rpavlik/PS2-Breakout-Board/PS2-Breakout-single.kicad_pcb

## KiCad design PS2-Breakout-single.kicad_pcb (2019-10-01)

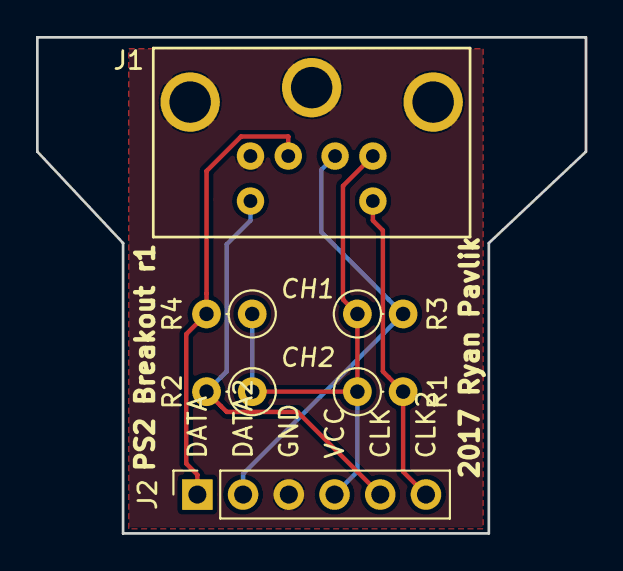
[picture p1: board PS2-Breakout-single.kicad_pcb from above]

Board: 2 copper layers, 30.5 x 27.6 mm, 6 parts (0 on the bottom side), 6 nets.

Parts:
J1: PS2-MINIDIN6-FEMALE; MINI-DIN-6-FULL-SHIELD
J2: Conn_01x06_Male; PinSocket_1x06_P2.54mm_Vertical
R1, R2, R3, R4: 10K; R_Axial_DIN0207_L6.3mm_D2.5mm_P2.54mm_Vertical

Connections:
/CLK: J1.5, J2.5, R2.2
/CLK2: J1.6, J2.6, R1.2
/DATA: J1.1, J2.1, R4.2
/DATA2: J1.2, J2.2, R3.2
GND: J1.3, J1.7, J2.3
VCC: J1.4, J2.4, R1.1, R2.1, R3.1, R4.1
