rpavlik/PS2-Breakout-Board/(threads)

Thread 2 (2017-07-26):

Fix PS/2 socket footprint

rpavlik, 2017-07-26:
Holes for actual pins are a bit too small. Alignment: not sure, worth double-checking with a fresh socket that I haven't monkeyed with.

Also, the center mounting/grounding pin hole could probably be a little bit bigger - it does go in, and it does look like it's designed to snap in, but a little more room is probably not a bad idea.

Thread 6 (2017-07-26):

Adjust silkscreen outline for PS2 socket

rpavlik, 2017-07-26:
It only needs to be roughly as wide as the distance between the center of the two ground/mounting holes - not the full width that it is now. That means it should probably be a broken box to avoid conflicts with the pads.

Thread 7 (2017-07-27):

PS/2 socket footprint mirrored in r1

rpavlik, 2017-07-27:
This would be my big "oopsie" for the R1 board - I apparently got the pinout of the port mirrored when making the footprint. This means a few things, if you connect a port and keyboard without board rework:

- Channel 1 (data/clk) and Channel 2 (data2/clk2) are swapped - no big deal except...
- GND and VCC are swapped (so now you're pulling down to gnd and you've got vcc on your ground plane, as well as your shield, etc... - basically a dead short once you plug a keyboard in...)

## Workarounds:

### The hard way
- On the board front, cut a trace (to what I thought was VCC) and the thermal connections to the ground plane (to what I thought was GND)
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

- After mounting the port, solder small wires on the back of the board to replace those traces.
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

- Use the pullup pads and pinouts labeled for ch2 instead of ch1, since they're swapped.

### The easy way
Of course, realized only after I had already done the above. If your mounting requirements allow (and frankly, you could realistically change all board component mounting since it's pretty simple and all through-hole...)

*put the PS/2 port on from the "back side" of the board* - this will mirror the pins back, and everything will work the way it's supposed to.  (facepalm)
