rpavlik/PS2-Breakout-Board/(commit log)

2017-07-26 Initial commit - gitignore backups and gerber/drill
2017-07-26 Revision 1 plus some alternate historical layouts.
    [PS2-Breakout.kicad_pcb, PS2-Breakout.sch, attempt-without-reorg.kicad_pcb, good-dual-layer-no-fills.kicad_pcb]
2017-07-26 Remove old backup copies of pcb
    [attempt-without-reorg.kicad_pcb, good-dual-layer-no-fills.kicad_pcb]
2017-07-26 Add and use the custom component/footprint in this project.
2017-07-26 Add script for git clean/smudge filters
2017-07-26 Commit changes performed by gitattributes clean filter.
    [PS2-Breakout.sch]
2019-10-01 Fix footprint
2019-10-01 Update to new kicad, and fix layout
    [PS2-Breakout.kicad_pcb, PS2-Breakout.sch]
2019-10-01 start of advanced schematic
    [PS2-Breakout-Advanced.sch, PS2-Breakout-single.kicad_pcb]
